PotjehPronasaoRakiju/PCB-designs/PreciseTempMeasurement.kicad_pcb

## KiCad design PreciseTempMeasurement.kicad_pcb (2026-02-01)

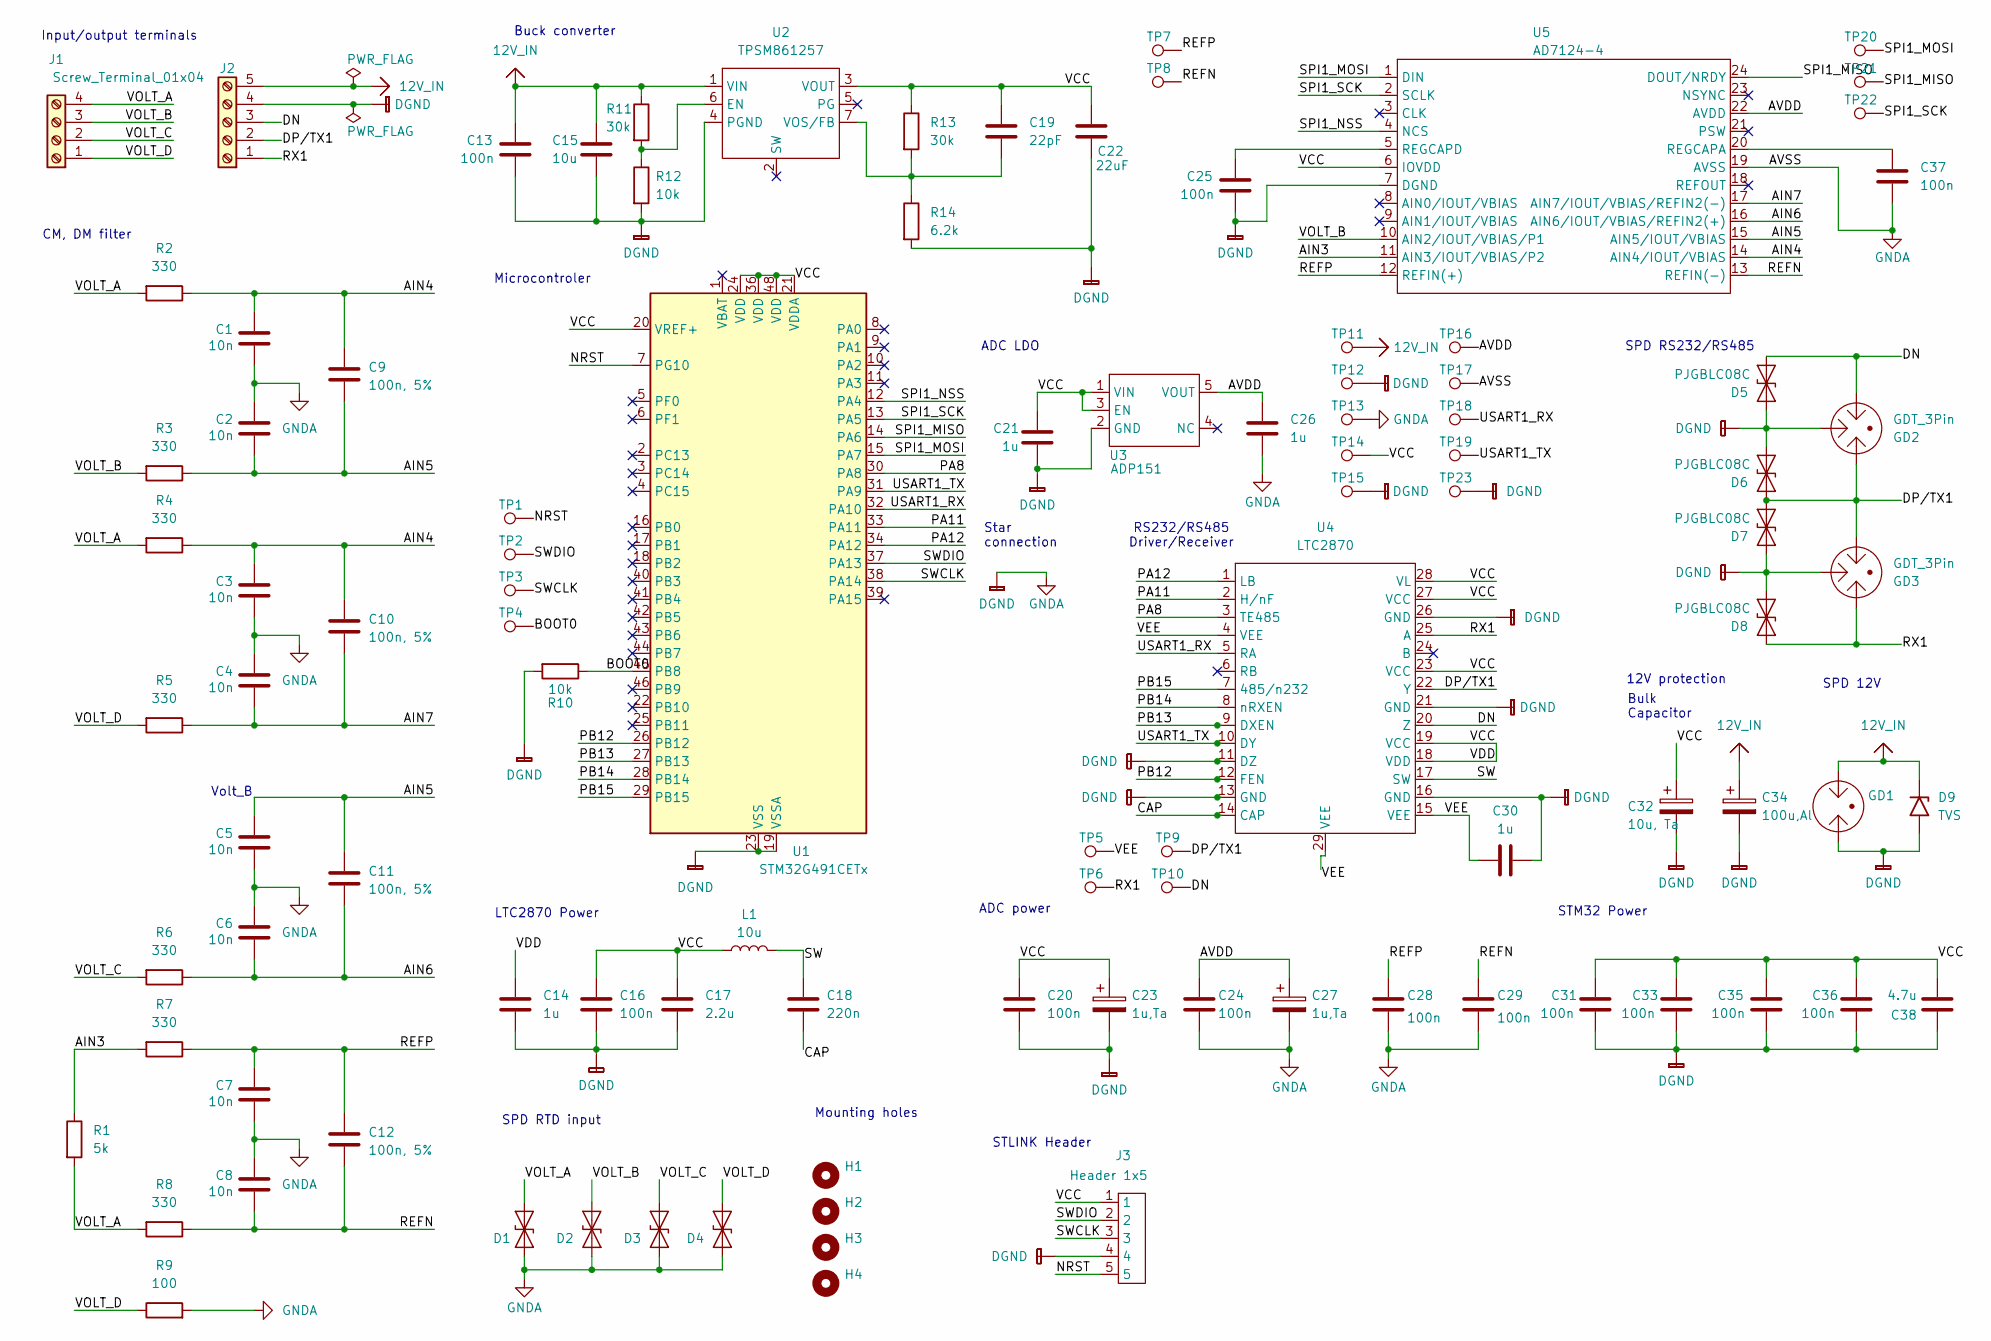
[picture p1: schematic PreciseTempMeasurement.kicad_sch, Precise Temperature Measurement Board]

Parts:
C1, C2, C3, C4, C5, C6, C7, C8: 10n; 0805; Part no. 581-08051C103J4Z2A
C9, C10, C11, C12: 100n, 5%; 0805; Part no. 77-VJ0805Y104JXARBC
C13, C16, C20, C24, C25, C28, C29, C31, C33, C35, C36, C37: 100n; 0603; Part no. 603-CC603KRX5R9BB104
C14, C21, C26, C30: 1u; 0805; Part no. 791-0805X105K250CT
C15: 10u; 1206; Part no. 963-TMK316BJ106KL-T
C17: 2.2u; 0805; Part no. 603-CC805KRX5R7BB225
C18: 220n; 0805; Part no. 603-CC805KRX7R8BB224
C19: 22pF; 0805; Part no. 77-VJ0805A220KXAMC
C22: 22uF; 1206; Part no. 581-KGM31AR70J226KU
C23, C27: 1u,Ta; 0603_pol; Part no. 74-TMCJ1C105MTRF
C32: 10u, Ta; 0805; Part no. 74-293D106X0010A2TE3
C34: 100u,Al; Radial; Part no. 232-25YXM100MEFR63X1
C38: 4.7u; 0805; Part no. 187-CL21A475KAQNNNE
D1, D2, D3, D4: ESDL2012MX4T5G; X4DFN-2; Part no. 863-ESDL2012MX4T5G
D5, D6, D7, D8: PJGBLC08C; SOD23; Part no. 241-PJGBLC08CR100001
D9: TVS; DFN-1610-2; Part no. 445-SY205245SLC
GD1: 2049-23; GDT 2 pin; Part no. 652-2049-23-BLF
GD2, GD3: GDT_3Pin; GDT 3 pin; Part no. 652-2046-23-C2LF
H1, H2, H3, H4: MountingHole; Hole 0.125 inch 3.175 mm
J1: Screw_Terminal_01x04; Terminal 1x4; Part no. 710-691244510004
J2: Screw_Terminal_01x05; Terminal 1x5; Part no. 710-691244510005
J3: Header 1x5; Part no. 649-77311-122-05LF
L1: 10u; 0806; Part no. 963-LBC2016T100K
R1: 5k; Resistor_THT; Part no. 71-Z201T5K0000VB
R2, R3, R4, R5, R6, R7, R8: 330; 0805; Part no. 756-WCR0805-330RFI
R9: 100; 0603; Part no. 71-CRCW0603100RFKECC
R10, R12: 10k; 0805; Part no. 603-SR0805KR-0710KL
R11, R13: 30k; 0805; Part no. 603-RT0805DRD0730KL
R14: 6.2k; 0805; Part no. 754-RR1220P-622D
TP1, TP2, TP3, TP4, TP5, TP6, TP7, TP8, TP9, TP10, TP11, TP12, TP13, TP14, TP15, TP16, TP17, TP18, TP19, TP20, TP21, TP22, TP23: TestPoint; Testpoint
U1: STM32G491CETx; QFP50P900X900X160-48N; Part no. 511-STM32G491CET6
U2: TPSM861257; VREG_TPSM861253RDXR; Part no. 595-TPSM861257RDXR
U3: ADP151; UJ_5_ADI; Part no. 584-ADP151AUJZ-3.3R7
U4: LTC2870; TSSOP-28_FE&slash_EB_LIT; Part no. 584-LTC2870IFE#TRPBF
U5: AD7124-4; SOP65P640X120-24N; Part no. 584-AD7124-4BRUZ

Connections:
12V_IN: C13.1, C15.1, C34.1, D9.1 (A1), GD1.3, J2.5, R11.1, TP11.1, U2.1 (VIN)
/AIN3: R1.1, R7.2, U5.11 (AIN3/IOUT/VBIAS/P2)
/AIN4: C1.1, C3.1, C9.1, C10.1, R2.1, R4.1, U5.14 (AIN4/IOUT/VBIAS)
/AIN5: C2.2, C5.1, C9.2, C11.1, R3.1, U5.15 (AIN5/IOUT/VBIAS)
/AIN6: C6.2, C11.2, R6.1, U5.16 (AIN6/IOUT/VBIAS/REFIN2(+))
/AIN7: C4.2, C10.2, R5.1, U5.17 (AIN7/IOUT/VBIAS/REFIN2(-))
/AVDD: C24.1, C26.1, C27.1, TP16.1, U3.5 (VOUT), U5.22 (AVDD)
/BOOT0: R10.1, TP4.1, U1.45 (PB8)
/CAP: C18.2, U4.14 (CAP)
/DN: D5.1 (A1), GD2.3, J2.3, TP10.1, U4.20 (Z)
/DP/TX1: D6.2 (A2), D7.1 (A1), GD2.1, GD3.3, J2.2, TP9.1, U4.22 (Y)
/NRST: J3.5, TP1.1, U1.7 (PG10)
/PA8: U1.30 (PA8), U4.3 (TE485)
/PA11: U1.33 (PA11), U4.2 (H/nF)
/PA12: U1.34 (PA12), U4.1 (LB)
/PB12: U1.26 (PB12), U4.12 (FEN)
/PB13: U1.27 (PB13), U4.9 (DXEN)
/PB14: U1.28 (PB14), U4.8 (nRXEN)
/PB15: U1.29 (PB15), U4.7 (485/n232)
/REFN: C8.2, C12.2, C29.1, R8.1, TP8.1, U5.13 (REFIN(-))
/REFP: C7.1, C12.1, C28.1, R7.1, TP7.1, U5.12 (REFIN(+))
/RX1: D8.2 (A2), GD3.1, J2.1, TP6.1, U4.25 (A)
/SPI1_MISO: TP21.1, U1.14 (PA6), U5.24 (DOUT/NRDY)
/SPI1_MOSI: TP20.1, U1.15 (PA7), U5.1 (DIN)
/SPI1_NSS: U1.12 (PA4), U5.4 (NCS)
/SPI1_SCK: TP22.1, U1.13 (PA5), U5.2 (SCLK)
/SW: C18.1, L1.2, U4.17 (SW)
/SWCLK: J3.3, TP3.1, U1.38 (PA14)
/SWDIO: J3.2, TP2.1, U1.37 (PA13)
/USART1_RX: TP18.1, U1.32 (PA10), U4.5 (RA)
/USART1_TX: TP19.1, U1.31 (PA9), U4.10 (DY)
/VCC: C14.1, C16.1, C17.1, C19.1, C20.1, C21.1, C22.1, C23.1, C31.1, C32.1, C33.1, C35.1, C36.1, C38.2, J3.1, L1.1, R13.1, TP14.1, U1.20 (VREF+), U1.21 (VDDA), U1.24 (VDD), U1.36 (VDD), U1.48 (VDD), U2.3 (VOUT), U2.14, U2.15, U2.16, U2.17, U2.18, U2.19, U3.1 (VIN), U3.3 (EN), U4.18 (VDD), U4.19 (VCC), U4.23 (VCC), U4.27 (VCC), U4.28 (VL), U5.6 (IOVDD)
/VEE: C30.1, TP5.1, U4.4 (VEE), U4.15 (VEE), U4.29 (VEE)
/VOLT_A: D1.1 (A1), J1.4, R1.2, R2.2, R4.2, R8.2
/VOLT_B: D2.1 (A1), J1.3, R3.2, U5.10 (AIN2/IOUT/VBIAS/P1)
/VOLT_C: D3.1 (A1), J1.2, R6.2
/VOLT_D: D4.1 (A1), J1.1, R5.2, R9.1
DGND: C1.2, C2.1, C3.2, C4.1, C5.2, C6.1, C7.2, C8.1, C13.2, C14.2, C15.2, C16.2, C17.2, C20.2, C21.2, C22.2, C23.2, C24.2, C25.2, C26.2, C27.2, C28.2, C29.2, C30.2, C31.2, C32.2, C33.2, C34.2, C35.2, C36.2, C37.2, C38.1, D1.2 (A2), D2.2 (A2), D3.2 (A2), D4.2 (A2), D5.2 (A2), D6.1 (A1), D7.2 (A2), D8.1 (A1), D9.2 (A2), GD1.1, GD2.2, GD3.2, J2.4, J3.4, R9.2, R10.2, R12.2, R14.2, TP12.1, TP13.1, TP15.1, TP17.1, TP23.1, U1.19 (VSSA), U1.23 (VSS), U1.35 (VSS), U1.47 (VSS), U2.4 (PGND), U3.2 (GND), U4.11 (DZ), U4.13 (GND), U4.16 (GND), U4.21 (GND), U4.26 (GND), U5.7 (DGND), U5.19 (AVSS)
unnamed: R11.2, R12.1, U2.6 (EN)
unnamed: C19.2, R13.2, R14.1, U2.7 (VOS/FB)
unnamed: C37.1, U5.20 (REGCAPA)
unnamed: C25.1, U5.5 (REGCAPD)

Notes on the sheet:
Microcontroler
SPD 12V
CM, DM filter
Buck converter
Star connection
SPD RTD input
Mounting holes
RS232/RS485 Driver/Receiver
STLINK Header
Input/output terminals
LTC2870 Power
ADC LDO
SPD RS232/RS485
STM32 Power
ADC power
Bulk Capacitor
12V protection
Volt_B

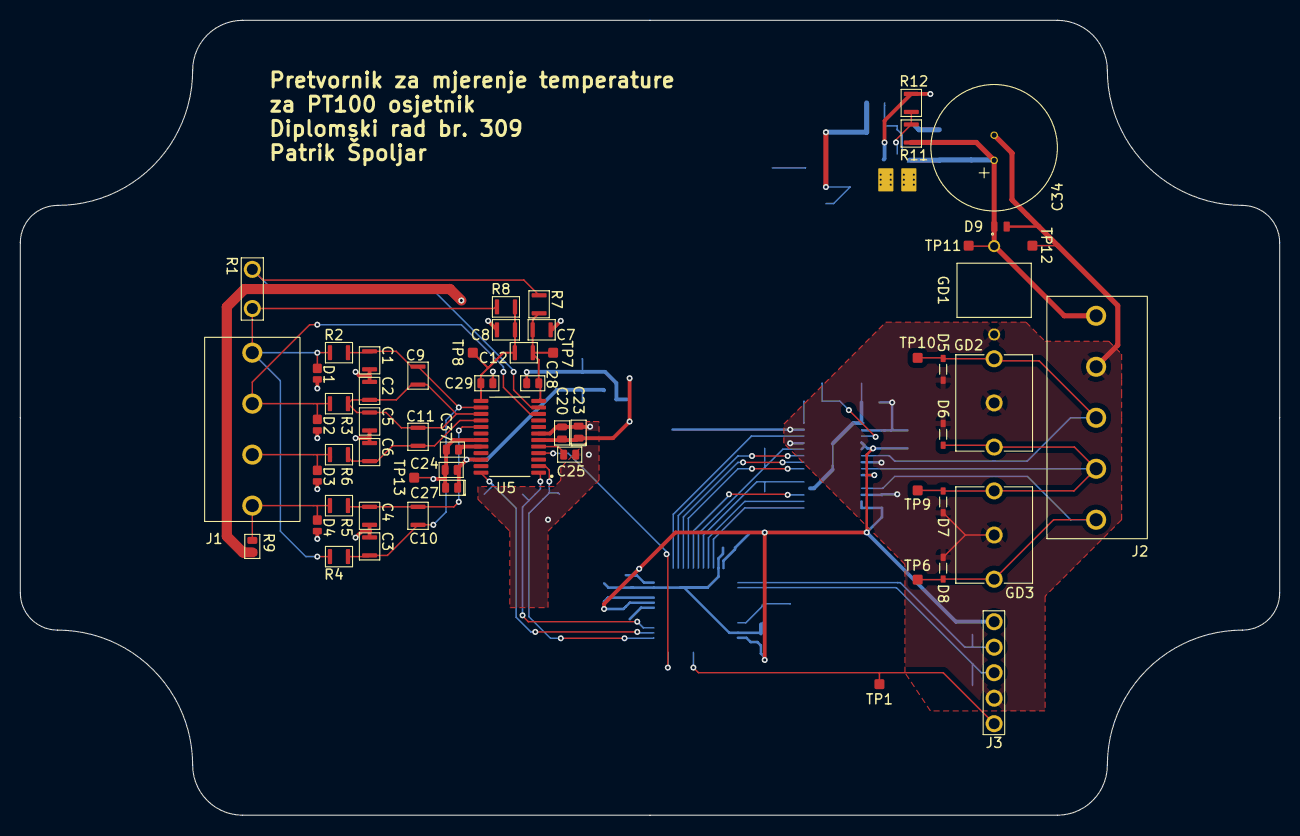
[picture p2: board PreciseTempMeasurement.kicad_pcb from above]

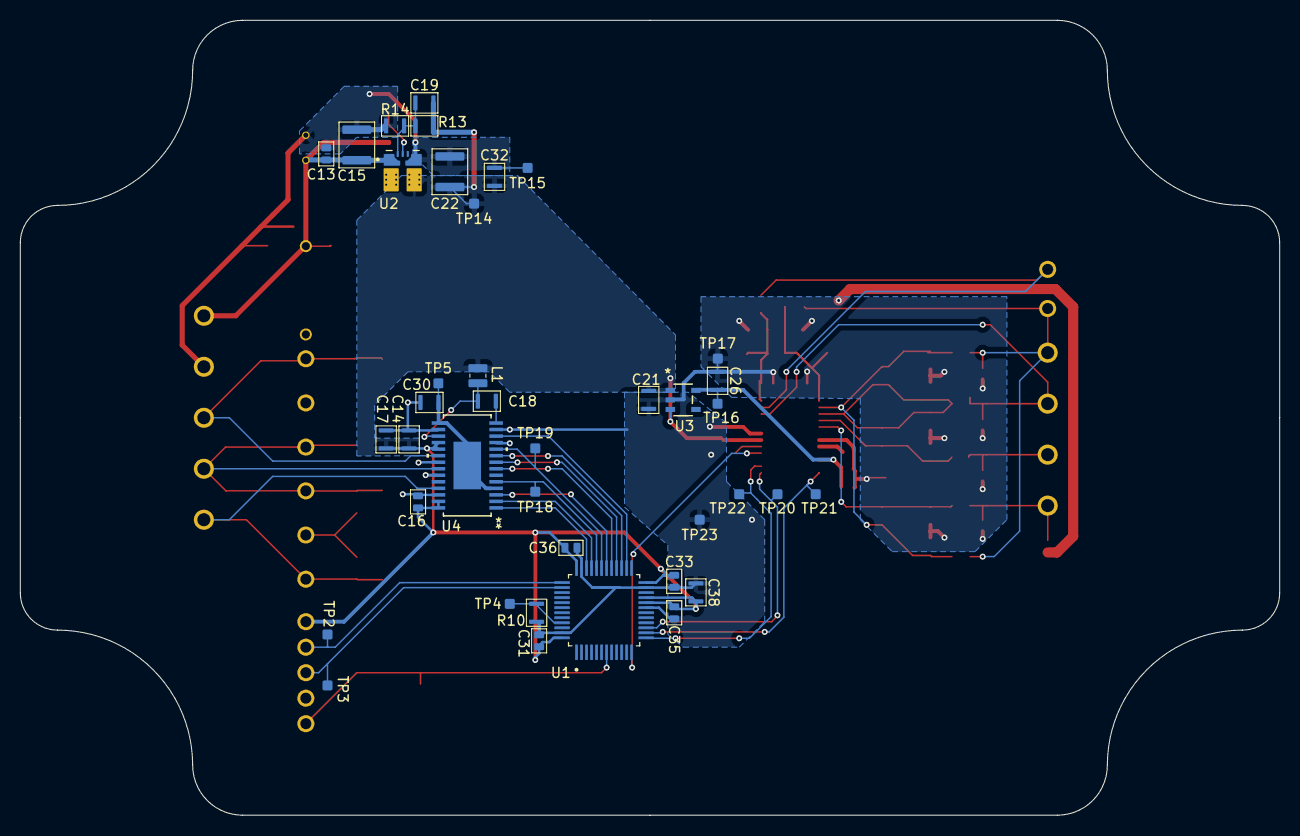
[picture p3: board PreciseTempMeasurement.kicad_pcb from below]

Board: 2 copper layers, 125.5 x 79.2 mm, 100 parts (39 on the bottom side), 42 nets.
