PotjehPronasaoRakiju/PCB-designs/(commit log)

2026-02-01 Rev A: initial PCB Design
    [PreciseTempMeasurement.csv, PreciseTempMeasurement.kicad_pcb, PreciseTempMeasurement.kicad_sch]
2026-02-01 Delete ~PreciseTempMeasurement.kicad_sch.lck
    .gitignore error
